AlfonsoJLuna/kicad-libs/README.md

# kicad-libs

KiCad libraries (symbols, footprints and 3D models) that I create when I need to use a component which is not present in the official KiCad repositories.

Some of them are minor variations of the official libraries:

* https://gitlab.com/kicad/libraries/kicad-symbols
* https://gitlab.com/kicad/libraries/kicad-footprints
* https://gitlab.com/kicad/libraries/kicad-packages3D
