AlfonsoJLuna/kicad-libs/(commit log)

2019-04-19 Add levelshifter and power symbols
2019-05-08 Add conn, levelshifter, power components
2020-06-17 Updated footprints
    [Button_8mm.step]
2020-12-24 Organized capacitors
2021-02-13 Added connectors, improved display footprints
